msmcs-robotics/3d-models/readme.md

# 3D-Models

> Note: MSMCS Robotics Uses a **Promega M30** printer, so gcode may vary.
