msmcs-robotics/3d-models/promega3d-parts/External Filter Fan/RV7/Revision Notes.rtf

Revision Notes
External Filter Fan_RV7_1:
• New re-design based given constraints: filter should stand out, smooth, mass reduction, simple form, Strcutural printing mode (0.75 extrusion width, 0.3 layer height).
• Accomplishment: Not tested.
• Issues: Not Tested.
External Filter Fan_RV7_2:
• Premptively changed extrusion width to 1mm for structural printing mode (as requested)
• Accomplishments: Outer Fan Clip successfull. Part rigidity adequate
• Issues: Filter dimensions (length) is too short. Too much mass. Not a fixation on the blower side.
External Filter Fan_RV7_3:
• Changed filter length to 60 mm.
• Accomplishments: None.
• Issues: No enough clearance.
External Filter Fan_RV7_4:
• Added blower clip with a snap fit configuration. Reduced mass by reducing fillet on the duct edge (4 mm radius). Increased length to 60.2 mm
• Accomplishments: Filter fits. Bottom layer thickness provides enough rigidity (2.4 mm)
• Issues: Snap method is not reliable, due to wall flexibility. Had a request to remove visibility of filter. Lack of flexural resistance. M3 screws thru hole is too small.
External Filter Fan_RV7_5:
• Removed filter visibility. Switched to an interal clip fixation to blower. Increased fillet to 6 mm. Increased M3 thru hole to 4 mm.
• Accomplishments: M3 thru hole is successful. Internal clip successfull. Rigidity is confirmed.
• Issues: Air gap at the front region of the blower fan. Needs cover. Filter insert clearance taken up by fillet. Request to print in different print orientation. Request for shorter M3 screws. Overhang difficulties on the internal clip. Pan head clearance issues
External Filter Fan_RV7_6:
• Added front cover to the blower fan. Added filter fan clearance. Added chamfer to overhangs. Reoriented print base. Accomodate for M3 x 10. Adjusted pan head clearance issue.
• Accomplishments: Overhang compensation successful. Pan head clearance successful. Filter fan clearance successfull.
• Issues: Needs washer. Accomodate for length discrepancy.
External Filter Fan_RV7_7:
• Switched to M3 x12 and height compensation for washer input.
• Accomplishments: New print base approved. Height compensation and new screw switch succesfull
• Issues: Blower internal clip is too small (0.7 mm under model dimensions). The blower dimensions are out-dated as well. Needs update.
External Filter Fan_RV7_8:
• Added 0.6 mm total clearance for internal clip, side region (using updated blower dimensions).
• Accomplishments: Side clearance for internal clip successful.
• Issues: Internal clip needs larger clearance on top region.
External Filter Fan_RV7_9:
• Added 0.6 mm total clearance for internal clip, top region, (using updated blower dimensions).
• Accomplishments: Clip clearance is sufficient.
• Issues: Filter clearance is not adequate (started printing with production printers, need modifications). Inconsistent bed adhesion (regional).
External Filter Fan_RV7_10:
• New filter clearance (60.4 x 13.3). Addressed bridging issues with the blower cover region. Addressed minor face misalignment issues. Added custom brim.
• Accomplishments: Better bridging performance. Custom brim performs function adequately.
• Issues: Subtle bridging issues need to be addressed. Increase filter fan clearance.
External Filter Fan_RV7_11:
• Increased filter clearance to 61 x 14 mm. Fixed model-based, minor bridging issue.
• Accomplishments: Pending.
• Issues: Pending.
External Filter Fan_RV7_12:
• Added changes make inverted printed plane possible. (along z axis)
• Accomplishments: Print dimensions more accurate. Needs support though.
• Issues: Pending.
