msmcs-robotics/3d-models/promega3d-parts/Quad-Mega Adapter/Mega Adapter 1.0/Revision Notes.rtf

Revision Notes
Mega Adapter (& Mirrored)_2:
• Change M3 screw position to allow tightening of printed parted into quad and allow addition fixation of the quad itself (between its two parts)
• Accomplishment: Screws into the quad, without problems (assembly-wise)
• Issues: Sliding interface with x shaft was: ABSR-chrome plate. Not good, switch to igus bearings.
Mega Adapter (& Mirrred)_3:
• Added igus clearance fitting
• Accoplishment: Proof of concept confirmed. Can fit sheet-metal-intended igus bearings into printed part.
• Issues: The igus bearing barely fits into the clearance. Cannot sliding x shaft into igus bearings. Needs more clearance adjustment.
Mega Adapter (& Mirrored)_4:
• Increase diam clearance in igus bearing fitting, based on diams measured when igus bearing was on x shaft.
• Accomplishment: X shaft can slide into bearing. Igus bearings install cleanly into printed part.
• Issues: Too much frictional load (seen in one igus bearing interface). Increase igus bearing clearance.
Mega Adapter (& Mirrored)_5:
• Increased igus bearing fitting diam. to reduce fricational load
• Accomplishment: Slides better.
• Issues: Need to address integration of fan mounts, cable harness, and bed switch holder. Current adapter design cannot conform adequately without serious modifications to the already-made parts. Will have to do a major revision.
• REFER TO MEGA ADAPTER 2.0
