msmcs-robotics/3d-models/promega3d-parts/Quad-Mega Adapter/Mega Adapter 2.0/Revision Notes.rtf

Revision Notes:
Mega Adapter 2.0.1:
• New adapter design. Conforms to cable harness M3 thru holes. Conforms to fan mount position. Secures to quad extruder in all 3 axes. ( 6 screws)
• Accomplishment: Cable harness attachment sucessfull. Quad extruder attachment successful. Igus bearin and x shaft installation sucessfull. Adequate frictional loading.
• Issues: Print issues with M3 pan head clearance.
Mega Adapter 2.0.2:
• Resolved M3 pan head overhang issue.
• Accomplishment: M3 pan head placement is accurate.
• Issues: No adaptation to the bed switch.
Mega Adapter 2.0.3:
• Added bed switch adaption. New Offset config values (signs are not confirmed, values are not confirmed):
With Lever: X-3.5 Y37.45 (Model Values)
W/o lever: X-3.5 Y30 (Model Values)
• Accomplishment: Bed switch toggle between disengage and engage is sucessfull. Minimal possibility of snagging when bed hits engaged bed switch.
• Issues: Bed Switch not well secured, in the z direction
Mega Adapter 2.0.4:
• New bed switch positioning solution. Offset values will be given when functionality is verified.
• Accomplishment: Bed switch secure in the z direction. The disengage position is fully fixated.
• Issues: The engage position is partially fixated, wobble in the XY plane. The wires coming of the endstop are causing clearance problems.

Mega Adapter 2.0.5:
• Applied same concept of disengage position's fixation to the the engage position. Added wire clearance
• Accomplishment: Wire clearance succesffull. Engaged position has better fixation, not fully acceptable yet.
• Issues: Modified heater block for quad conflicts with disengaged position of the bed switch. Need new position for disengaged bed switch.
Mega Adapter 2.0.6:
• New bed switch position configuration
• Accomplishment: Bed switch configuration is successfull.
• Issues: X axis range is limited because the fans hit the idlers. No consideration of CoreXY belt clamping
Mega Adapter 2.0.7:
• New CoreXY clamping integration. Lowered quad position (relative to X shaft) to for belt clearance.
• Accomplishment: Integration successful.
• Issues: Pan head crushes into print during clamping (needs washer consideration). Left over CoreXY belt needs routing. Plates rotate during fixation, needs to stay straight. Need larger print thickness to clamp CoreXY down harder. Need wire clearance for the back motors. Need thru hole for the cable harness. CRITICAL ISSUE: Flexing occurs where the belt clamping is done, the extension(from the base to the clamping position is too high). May have to reconsider reposition of quad for better rigidity. New revision may be pursued.
Mega Adapter 2.0.8:
• Added support bars close to the application force, should reduce flexing by some degree. Switched to a snug fit belt fixation method. Hid the termation of the belt fixation.
• Accomplishment: Flexion reduction successfull, now feasible fixation mechanism.
• Issues: Clearance issues with insertions of different parts. Needs thru hole for cable harness fixation. Needs more heater air gap. Current belt fixation method is not feasible.
Mega Adapter 2.0.9:
• Switching to a crimp-belt fixation method with a secondary clamping mechanism from the motors, as the quad head is fixed into place. Have a 4.0mm heater air gap. All insertion clearances adjusted for. Added better form factor (merging region between different printed parts).
• Accomplishment: CoreXY belt clamping partially successful. The grip is descent, needs a secondary reinforcement. Better form factor.
• Issues: Need secondary belt grip.
Mega Adapter 2.0.10:
• Added a secondary belt grip.
• Accomplishment: Belt grip successfull.
• Issues: Needs bed switch clearance increase.
Mega Adapter 2.0.11:
• Changed belt insertion direction. Changed direction of belt grip. Increased bed switch clearance to 3.5 mm (prev. 3.4). Minor asesthetic changes.
• Accomplishment: Bed switch clearance adequate. Asesthetic changes approved.
• Issues: Other bed switch clearance needs adjustment. Angle of belt mating is not completely functional
Mega Adapter 2.0.12:
• New orientation for belt mating and new insertion belt position. Increased bed switch clearance from 11 mm to 11.2 mm.
• Accomplishment: New Belt orientation is preffered,compared to other orientation. Bed switch performance is adequate (minor issues).
• Issues: Belt grip is not enough (too much clearance).
Mega Adapter 2.0.13:
• Decreased belt clearance from 1.2 to .95 mm (reference to smallest belt thickness in belt profile. Decreased m3 locknut clearance to 5.55 (prev. 5.6). Removed angled clearance and now a locknut insertion clearance with a screw length clearance (no bottoming out).
• Accomplishment: None.
• Issues: Belt mating starts slipping at high loads. Will play it safe and decrease mating clearance. M3 locknut clearances are not adequate. M3 tap holes are not helping assembly. M3 pan head clearance needs to be increased. Belt clamp through the quad head needs more clamping. Motor wire clearance needs to be addressed. Bed switch clearance needs improvement. One of the asesthetic fillets is hard to print.
Mega Adapter 2.0.14:
• Changed all M3 tap holes to thru holes (3.8 mm). Increased M3 pan head clearance to 6.5 mm. Decreased belt insertion clearance from 1.1 mm to 0.9 mm (quad should grip the belt tighter). Reduced belt tooth mating clearance from 0.1 mm (prev) to 0.05mm. Determined that there is no need for wire clearance accomodation. Reduced m3 lockunut insertion clearance to 5.45 mm (width & length) x 4.2 mm (height). Increased bed switch height clearance to 11.4 mm (prev 11.1). Changed asesthetic fillet to a 45 chamfer with a fillet transitioning toward the top.
• Accomplishment: Pending.
• Issues: Cable harness position is too low.
Mega Adapter 2.0.15:
• Shifted the cable harness location higher.
• Accomplishment: Bed switch functionality verified. Belt mating is quite good. M3 locknut clearance better. Quad belt grip better.
• Issues: Hitting limit switch is a problem. (both in x Y position). Address minor prnt issue with M3 lock nut casing.
Mega Adapter 2.0.16:
• Added heater cartidge wire clearance. Add extension to hit limit switch properly. Increase print base length by 3 mm.
• Accomplishment: Pending.
• Issues: Pending.
