msmcs-robotics/3d-models/promega3d-parts/Sliders/RV7/Revision Notes.rtf

Revision Notes
Slider_RV7_1:
• A cumulation of iteration designs on the z sliders. This is current production z slider iteration.
• Accomplishments: Dismissed
• Issues: "arms" are breaking during shipping. Needs z axis adjustability (+- 1mm)
Slider_RV7_2:
• Increase arm thickness by 50% (prev= 3.9 mm, new=5.85 mm). Added 0.8 +- mm z axis adjustment (limited by interference with M3 pan head)
• Accomplishments: Thickening completed.
• Issues: M3 nut can rotate freely when inserted. Need larger M3 thru slot.
Slider_RV7_3:
• Decreased M3 nut clearance to 5.5 mm, previous 5.7. Increased slot diameter to 3.6 mm
• Accomplishments: M3 slot clearance is verified.
• Issues: M3 nut is well-secured. Rough sliding (takes quiet a bit of force to slide it to position).
Slider_RV7_4:
• Increased nut clearance to 5.6 mm
• Accomplishments: Nut clearance is functional. Pending shipping test results
• Issues: Request to add fillets on corner.
Slider_RV7_5:
• Added corner reduction to intended edge.
• Accomplishments: Changes approved. Pending on test results.
• Issues: Nut clearance (on the fillet side) needs more clearance. Other side is fine.
Slider_RV7_6:
• Increased specific nut clearance to 5.7 x 4.3 mm (fillet side).
• Accomplishments: Samples worked.
• Issues: Batch prints have dimensional variances, need to adjust.
Slider_RV7_7:
• The nut clearance was adjusted for batch printing.
• Accomplishments: Pending.
• Issues: Pending.
