msmcs-robotics/3d-models/hello-world/stl/roundPhoneDock.stl

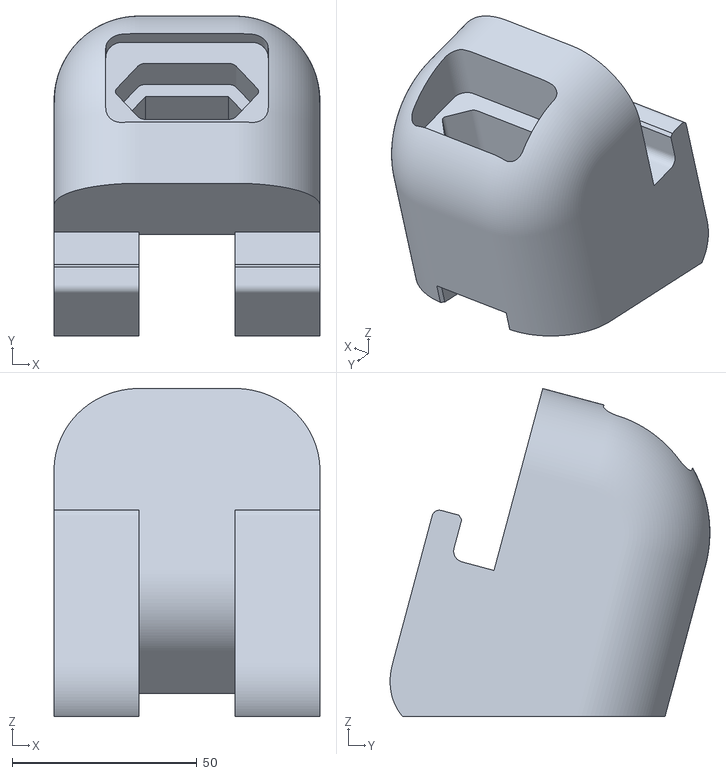
[picture p1: CAD file, 2021-11-17]
hello-world/stl/roundPhoneDock.stl
72.0 x 86.6 x 88.8
