msmcs-robotics/3d-models/mini-rockets/rocket_v2_fins.stl

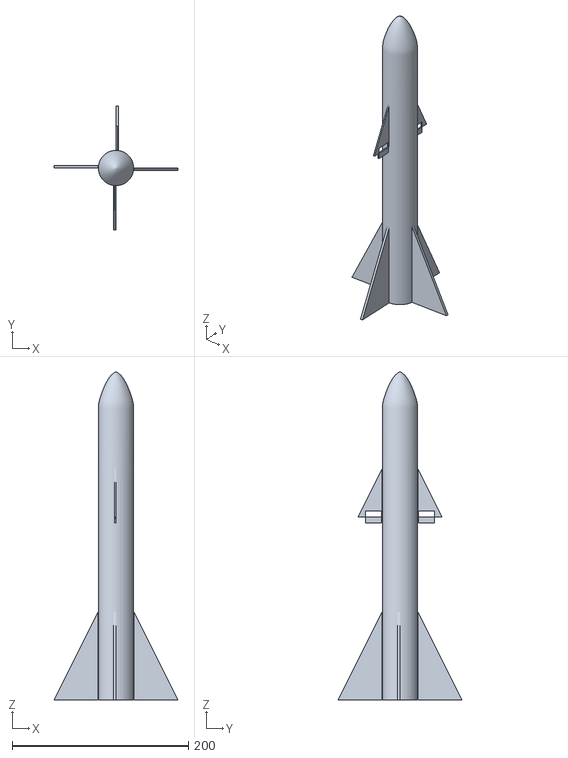
[picture p2: CAD file, 2022-01-28]
mini-rockets/rocket_v2_fins.stl
140.4 x 140.4 x 372.1
