msmcs-robotics/3d-models/promega3d-parts/External Filter Fan/RV3/External Filter Fan_RV3_LeftDuct_5.STL

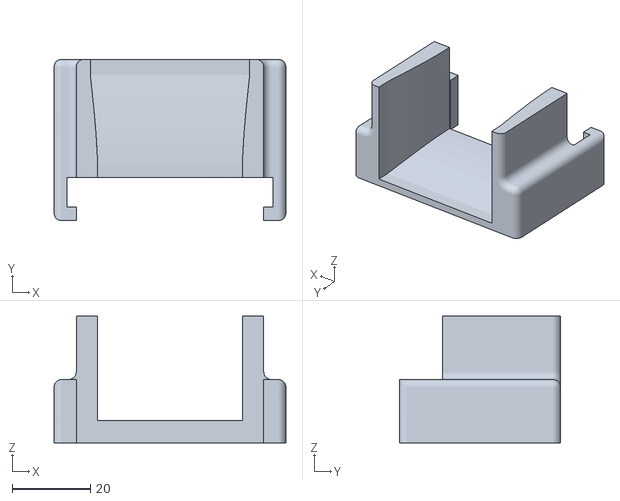
[picture p3: CAD file, 2022-01-12]
promega3d-parts/External Filter Fan/RV3/External Filter Fan_RV3_LeftDuct_5.STL
59.4 x 41.3 x 32.4
