msmcs-robotics/3d-models/promega3d-parts/External Filter Fan/RV4/External Filter Fan_RV4_LD_3.STL

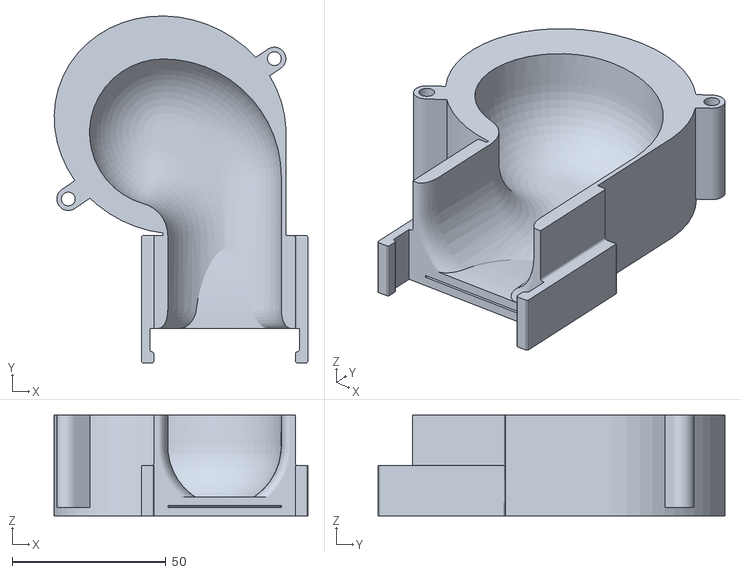
[picture p4: CAD file, 2022-01-12]
promega3d-parts/External Filter Fan/RV4/External Filter Fan_RV4_LD_3.STL
82.6 x 113.0 x 32.8
