msmcs-robotics/3d-models/promega3d-parts/External Filter Fan/RV5/External Filter Fan RV5_1.STL

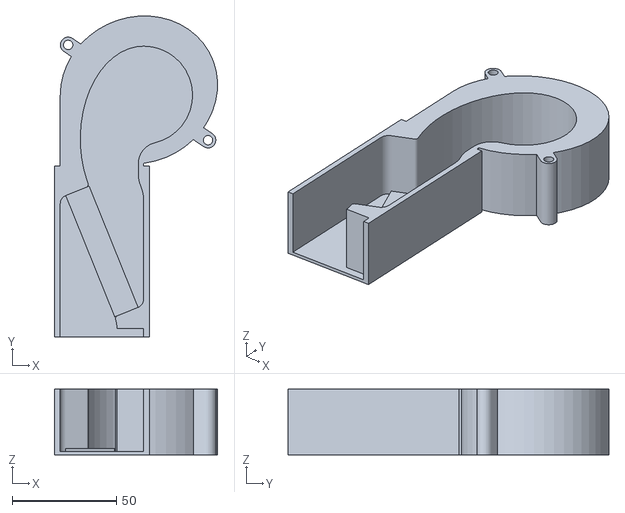
[picture p5: CAD file, 2022-01-12]
promega3d-parts/External Filter Fan/RV5/External Filter Fan RV5_1.STL
78.2 x 153.9 x 31.5
