msmcs-robotics/3d-models/promega3d-parts/External Filter Fan/RV7/External Filter Fan_RV7_2.STL

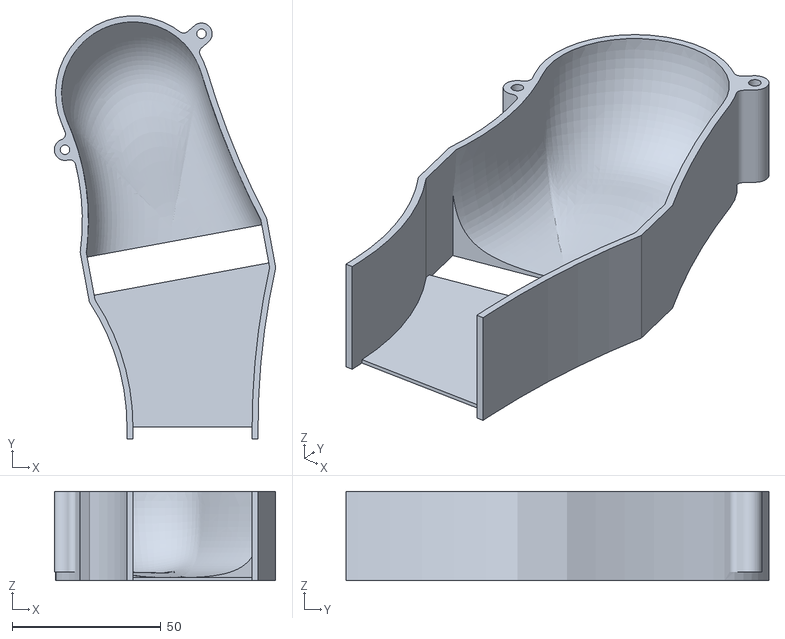
[picture p6: CAD file, 2022-01-12]
promega3d-parts/External Filter Fan/RV7/External Filter Fan_RV7_2.STL
74.3 x 142.0 x 30.0
