msmcs-robotics/3d-models/promega3d-parts/Sliders/RV7/Slider_RV7_6.STL

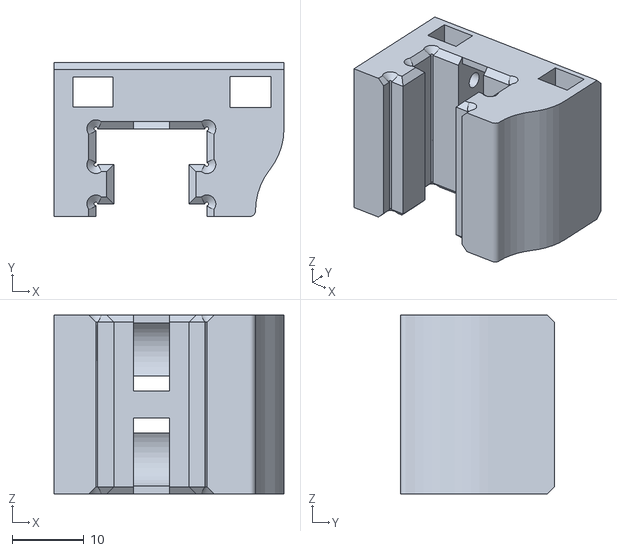
[picture p10: CAD file, 2022-01-12]
promega3d-parts/Sliders/RV7/Slider_RV7_6.STL
32.1 x 21.5 x 25.0
