msmcs-robotics/3d-models/promega3d-parts/Y Limit Switch Holder/Y Limit Switch Holder_RV3_10.STEP

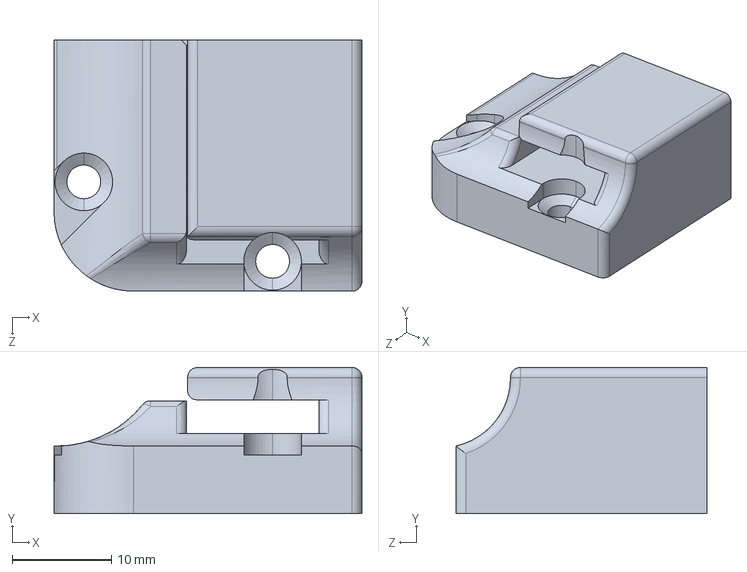
[picture p11: CAD file, 2022-01-12]
promega3d-parts/Y Limit Switch Holder/Y Limit Switch Holder_RV3_10.STEP
31.0 x 14.7 x 25.3 mm
