msmcs-robotics/3d-models/mini-rockets/rocket_v2.stl

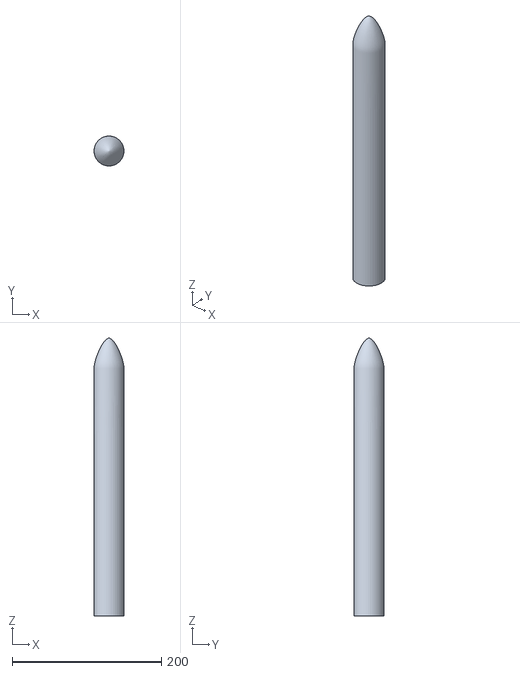
[picture p12: CAD file, 2022-01-28]
mini-rockets/rocket_v2.stl
40.0 x 40.0 x 372.1
