msmcs-robotics/3d-models/promega3d-parts/External Filter Fan/RV3/External Filter Fan_RV3_LeftFilter_7.STL

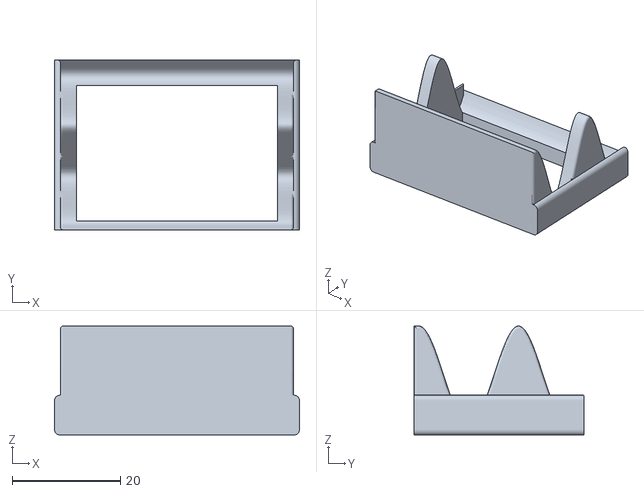
[picture p13: CAD file, 2022-01-12]
promega3d-parts/External Filter Fan/RV3/External Filter Fan_RV3_LeftFilter_7.STL
45.2 x 31.3 x 20.1
