msmcs-robotics/3d-models/promega3d-parts/External Filter Fan/RV4/External Filter Fan_RV4_RFC_1.STL

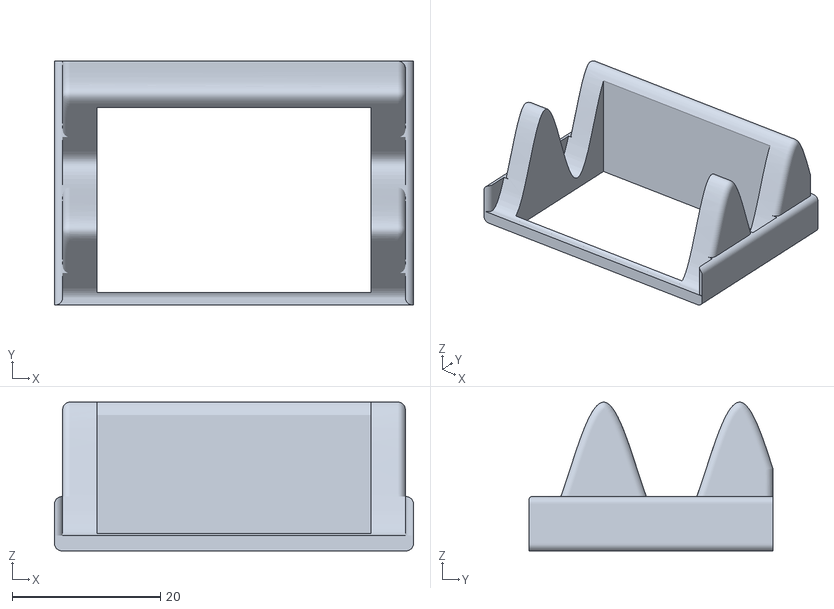
[picture p14: CAD file, 2022-01-12]
promega3d-parts/External Filter Fan/RV4/External Filter Fan_RV4_RFC_1.STL
48.5 x 33.0 x 20.1
