msmcs-robotics/3d-models/promega3d-parts/External Filter Fan/RV5/External Filter Fan RV5_4.STL

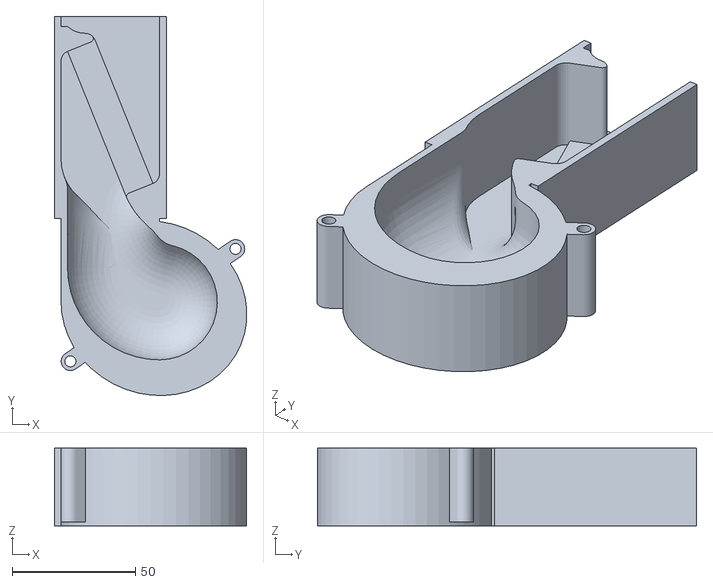
[picture p15: CAD file, 2022-01-12]
promega3d-parts/External Filter Fan/RV5/External Filter Fan RV5_4.STL
78.2 x 154.0 x 31.5
