msmcs-robotics/3d-models/promega3d-parts/Nozzle Fan Guide/Nozzle Fan Guide 2.0/Nozzle Fan Guide 2.0.1.STL

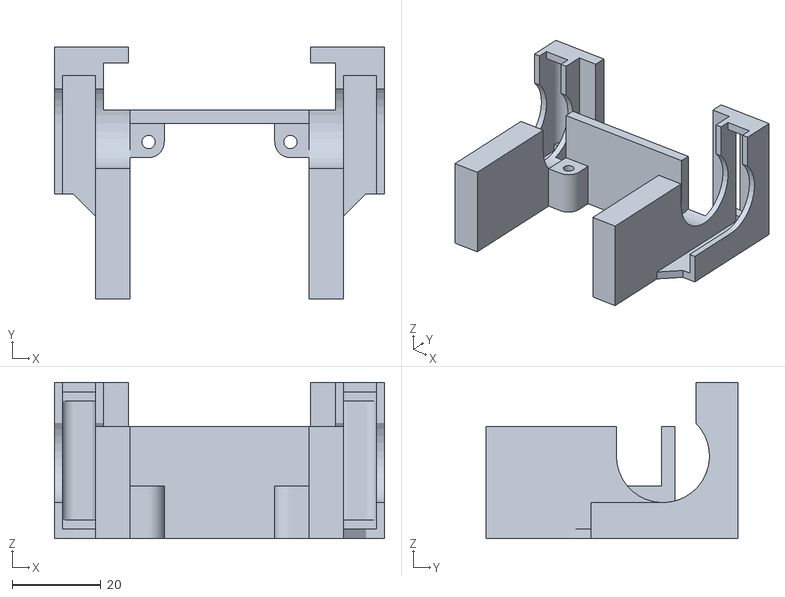
[picture p17: CAD file, 2022-01-12]
promega3d-parts/Nozzle Fan Guide/Nozzle Fan Guide 2.0/Nozzle Fan Guide 2.0.1.STL
74.5 x 57.0 x 35.3
