msmcs-robotics/3d-models/promega3d-parts/Quad-Mega Adapter/Mega Adapter 2.0/Mega Adapter 2.0.18.STL

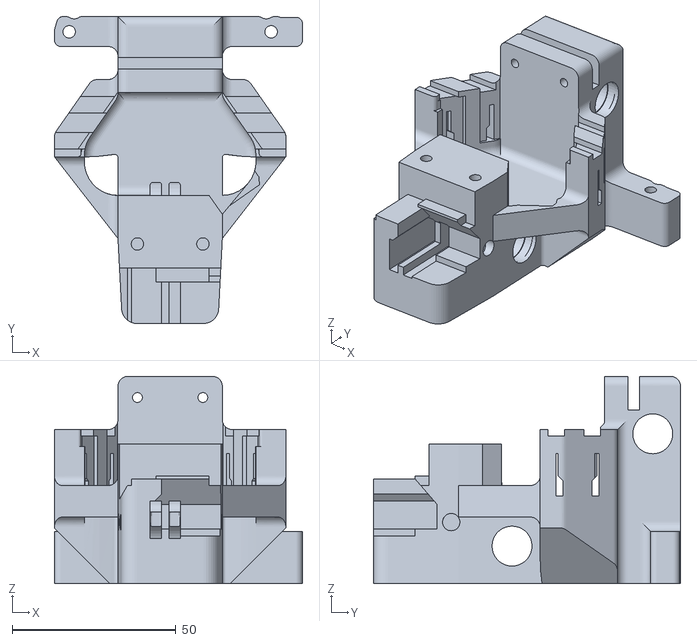
[picture p19: CAD file, 2022-01-12]
promega3d-parts/Quad-Mega Adapter/Mega Adapter 2.0/Mega Adapter 2.0.18.STL
75.8 x 93.8 x 63.3
