msmcs-robotics/3d-models/promega3d-parts/Y Limit Housing XL(For Long Motors)/Y Limit Housing XL V2_2.stl

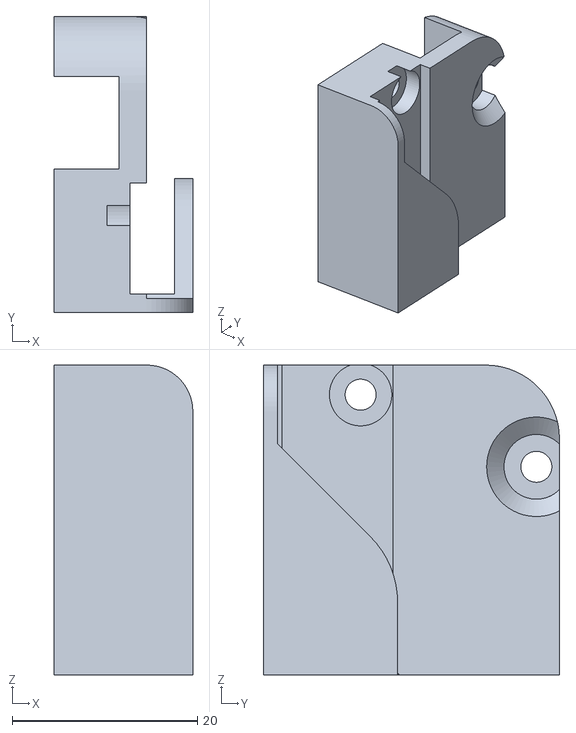
[picture p21: CAD file, 2022-01-12]
promega3d-parts/Y Limit Housing XL(For Long Motors)/Y Limit Housing XL V2_2.stl
15.0 x 32.0 x 33.5
