msmcs-robotics/3d-models/promega3d-parts/External Filter Fan/RV4/External Filter Fan_RV4_LD_1.STL

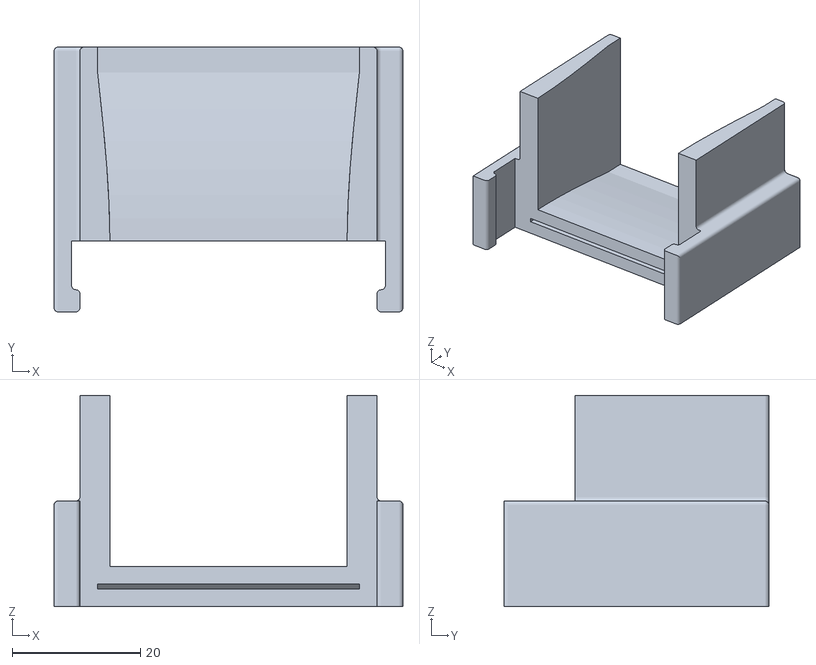
[picture p22: CAD file, 2022-01-12]
promega3d-parts/External Filter Fan/RV4/External Filter Fan_RV4_LD_1.STL
54.4 x 41.3 x 33.0
