msmcs-robotics/3d-models/promega3d-parts/External Filter Fan/RV7/External Filter Fan_RV7_12.STL

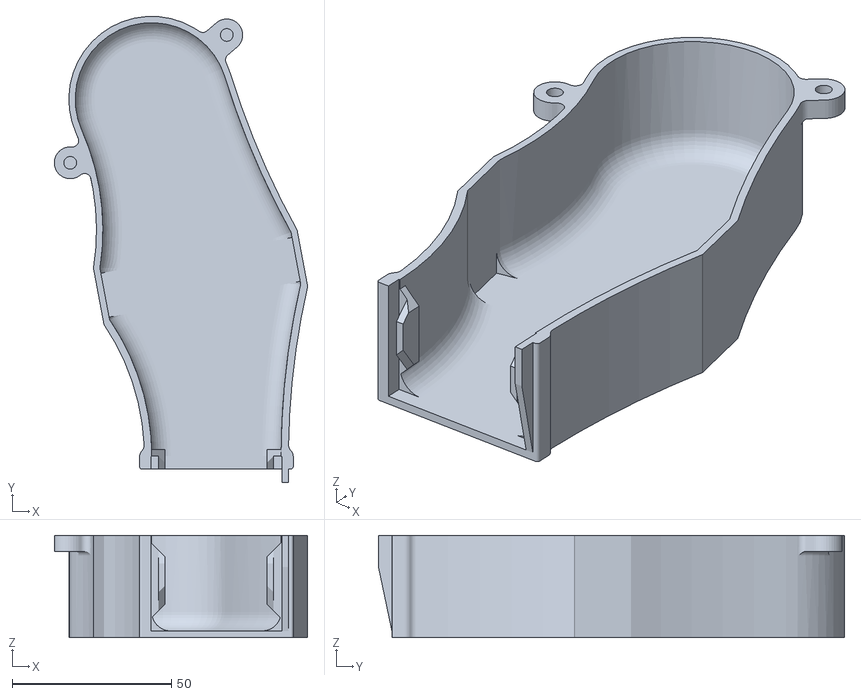
[picture p23: CAD file, 2022-01-12]
promega3d-parts/External Filter Fan/RV7/External Filter Fan_RV7_12.STL
79.5 x 146.2 x 32.1
