msmcs-robotics/3d-models/promega3d-parts/Nozzle Fan Guide/Nozzle Fan Guide 2.0/Nozzle Fan Guide 2.0.18.STL

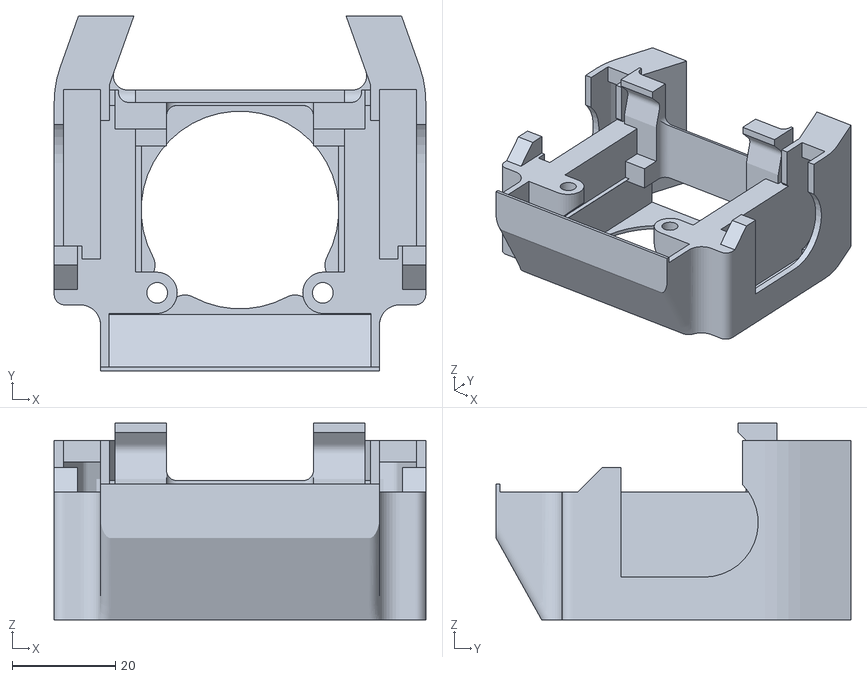
[picture p24: CAD file, 2022-01-12]
promega3d-parts/Nozzle Fan Guide/Nozzle Fan Guide 2.0/Nozzle Fan Guide 2.0.18.STL
71.8 x 68.6 x 38.0
