msmcs-robotics/3d-models/promega3d-parts/Quad-Mega Adapter/Mega Adapter 1.0/Mega Adapter Mirrored_4.STL

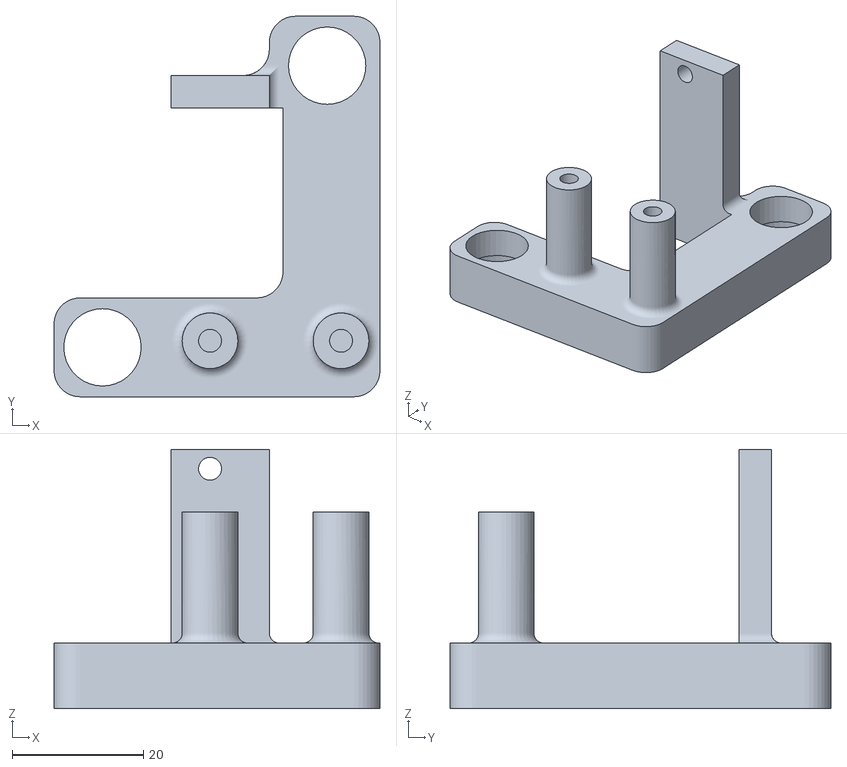
[picture p25: CAD file, 2022-01-12]
promega3d-parts/Quad-Mega Adapter/Mega Adapter 1.0/Mega Adapter Mirrored_4.STL
49.8 x 58.1 x 39.6
