msmcs-robotics/3d-models/promega3d-parts/Quad-Mega Adapter/Mega Adapter 2.0/Mega Adapter 2.0.10.STL

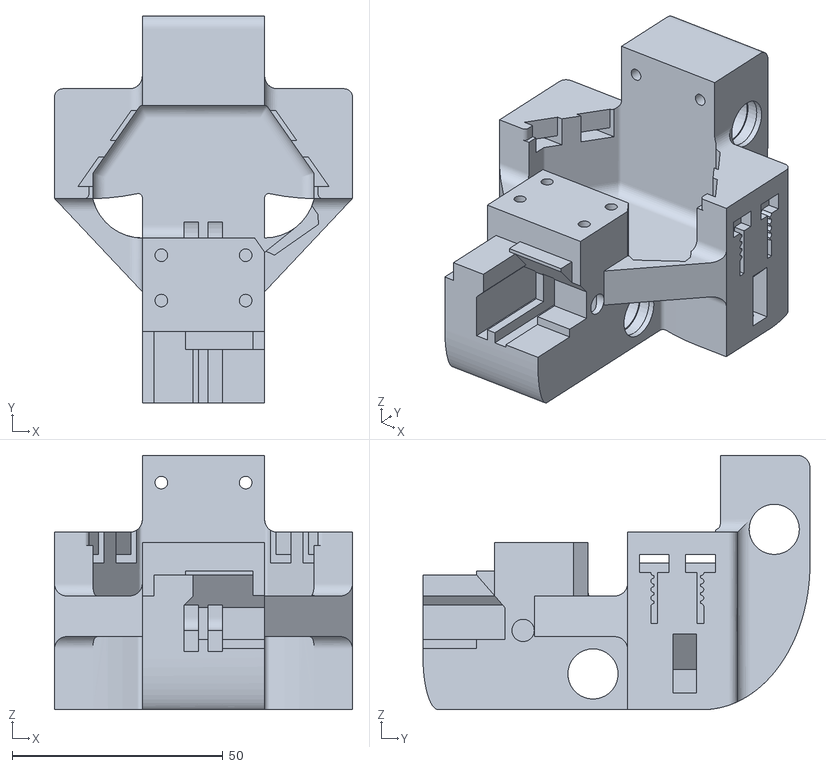
[picture p26: CAD file, 2022-01-12]
promega3d-parts/Quad-Mega Adapter/Mega Adapter 2.0/Mega Adapter 2.0.10.STL
70.7 x 91.8 x 60.3
