msmcs-robotics/3d-models/promega3d-parts/External Filter Fan/RV4/External Filter Fan_RV4_RFC_2.STL

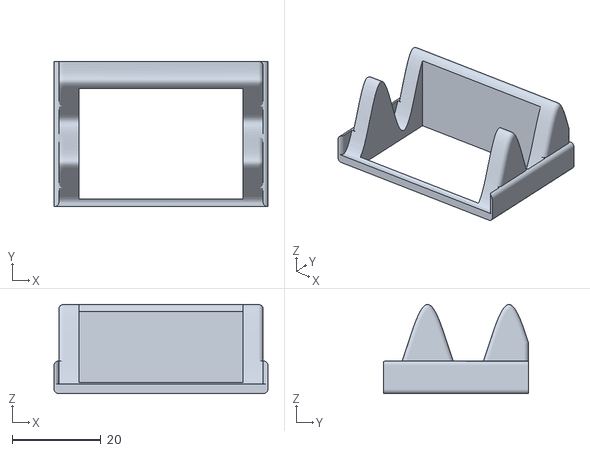
[picture p28: CAD file, 2022-01-12]
promega3d-parts/External Filter Fan/RV4/External Filter Fan_RV4_RFC_2.STL
48.3 x 32.8 x 20.1
