msmcs-robotics/3d-models/promega3d-parts/Nozzle Fan Guide/Nozzle Fan Guide 2.0/Nozzle Fan Guide 2.0.7.STL

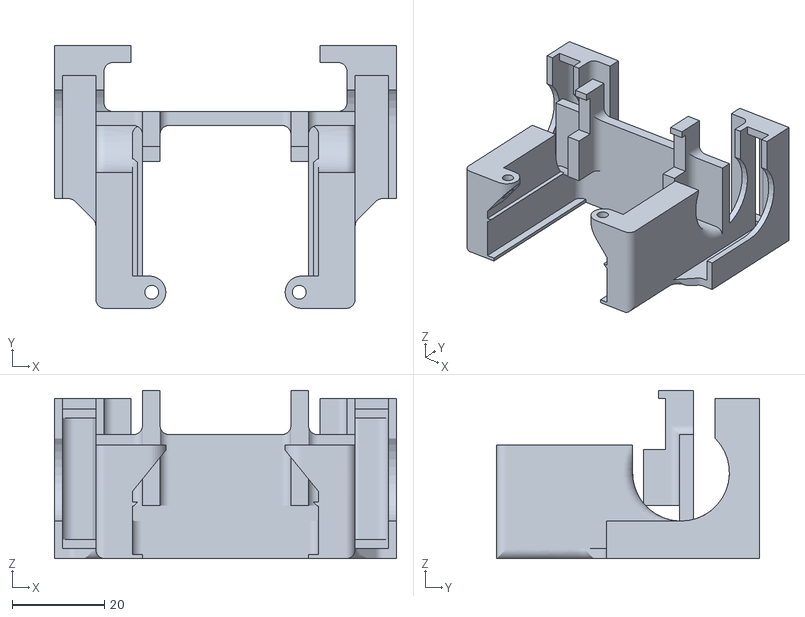
[picture p29: CAD file, 2022-01-12]
promega3d-parts/Nozzle Fan Guide/Nozzle Fan Guide 2.0/Nozzle Fan Guide 2.0.7.STL
74.2 x 57.0 x 36.5
