msmcs-robotics/3d-models/promega3d-parts/Quad-Mega Adapter/Mega Adapter 1.0/Mega Adapter Mirrored_1.STL

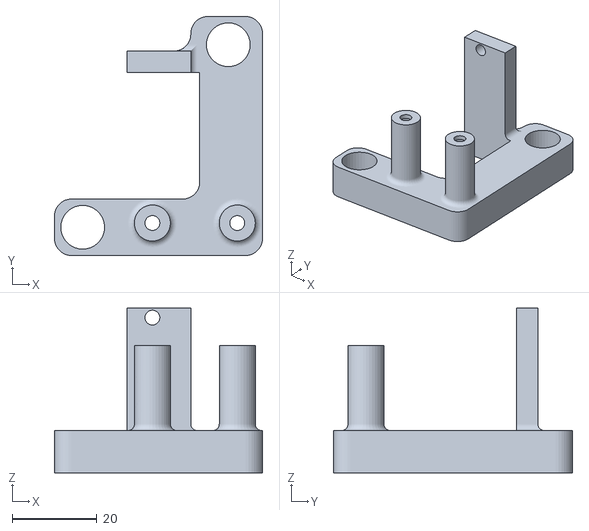
[picture p30: CAD file, 2022-01-12]
promega3d-parts/Quad-Mega Adapter/Mega Adapter 1.0/Mega Adapter Mirrored_1.STL
49.0 x 56.3 x 38.9
