msmcs-robotics/3d-models/promega3d-parts/Sliders/RV7/Slider_RV7_1.STL

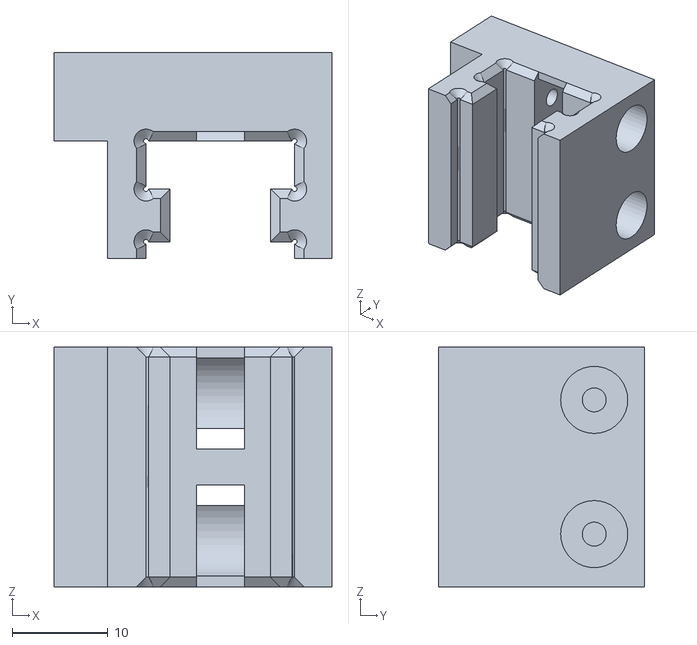
[picture p31: CAD file, 2022-01-12]
promega3d-parts/Sliders/RV7/Slider_RV7_1.STL
29.0 x 21.5 x 25.0
