msmcs-robotics/3d-models/promega3d-parts/External Filter Fan/RV3/External Filter Fan_RV3_LeftFilter_6.STL

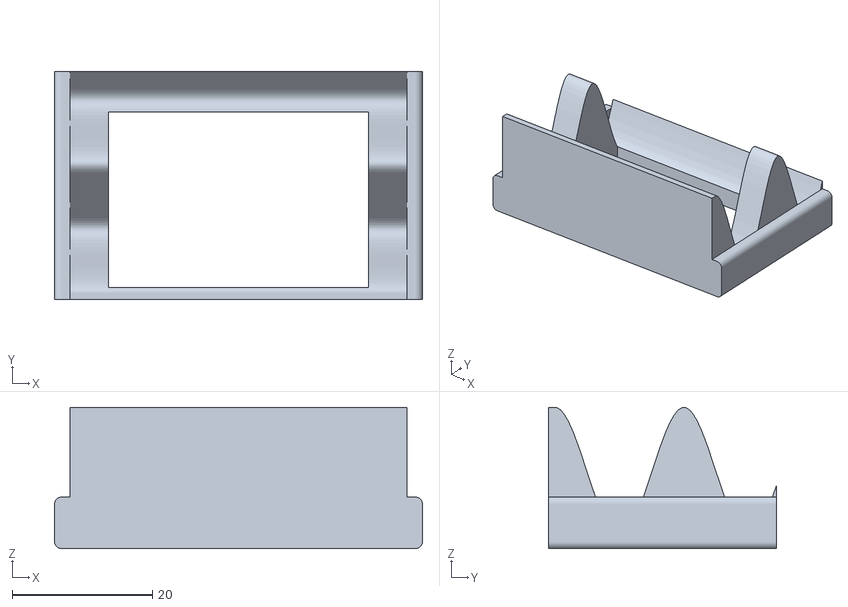
[picture p32: CAD file, 2022-01-12]
promega3d-parts/External Filter Fan/RV3/External Filter Fan_RV3_LeftFilter_6.STL
52.4 x 32.4 x 20.1
