msmcs-robotics/3d-models/promega3d-parts/External Filter Fan/RV4/External Filter Fan_RV4_RD_1.STL

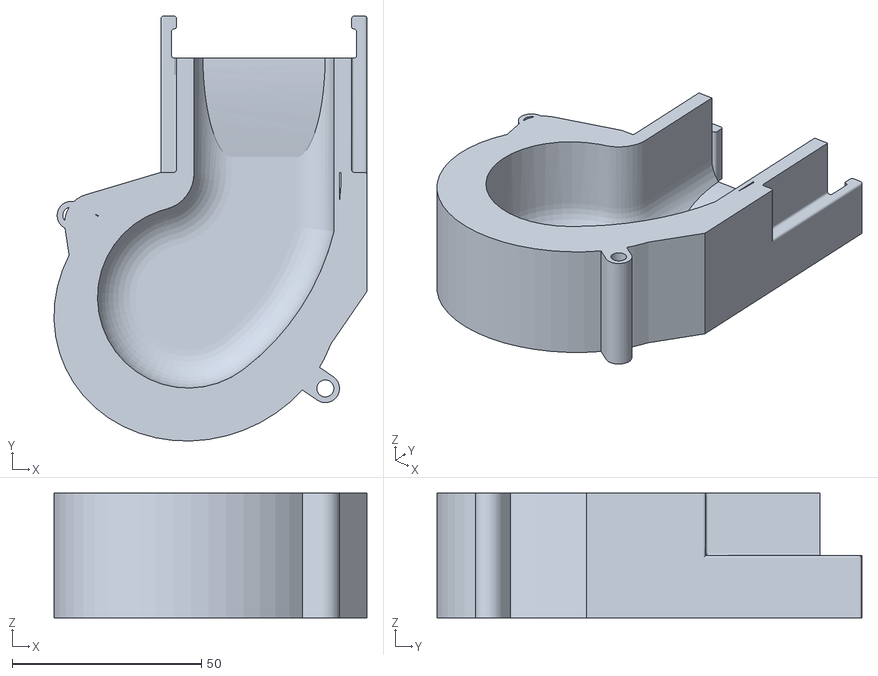
[picture p35: CAD file, 2022-01-12]
promega3d-parts/External Filter Fan/RV4/External Filter Fan_RV4_RD_1.STL
82.7 x 112.3 x 33.0
