msmcs-robotics/3d-models/promega3d-parts/External Filter Fan/RV7/External Filter Fan_RV7_4.STL

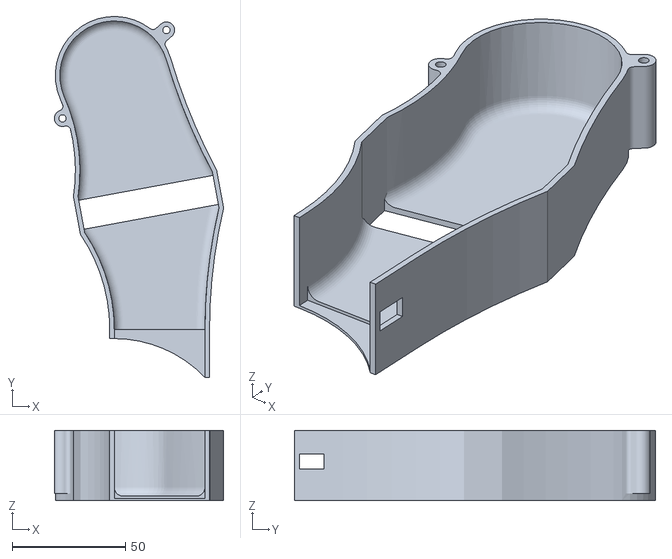
[picture p36: CAD file, 2022-01-12]
promega3d-parts/External Filter Fan/RV7/External Filter Fan_RV7_4.STL
74.6 x 159.1 x 30.9
