msmcs-robotics/3d-models/promega3d-parts/Quad-Mega Adapter/Mega Adapter 2.0/Mega Adapter 2.0.16.STL

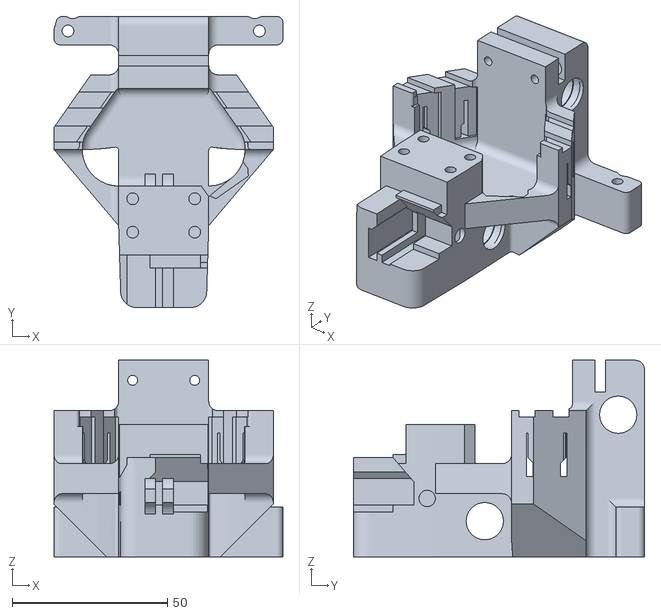
[picture p37: CAD file, 2022-01-12]
promega3d-parts/Quad-Mega Adapter/Mega Adapter 2.0/Mega Adapter 2.0.16.STL
73.8 x 93.8 x 63.3
