msmcs-robotics/3d-models/promega3d-parts/Quad-Mega Adapter/Mega Adapter 1.0/Mega Adapter_5.STL

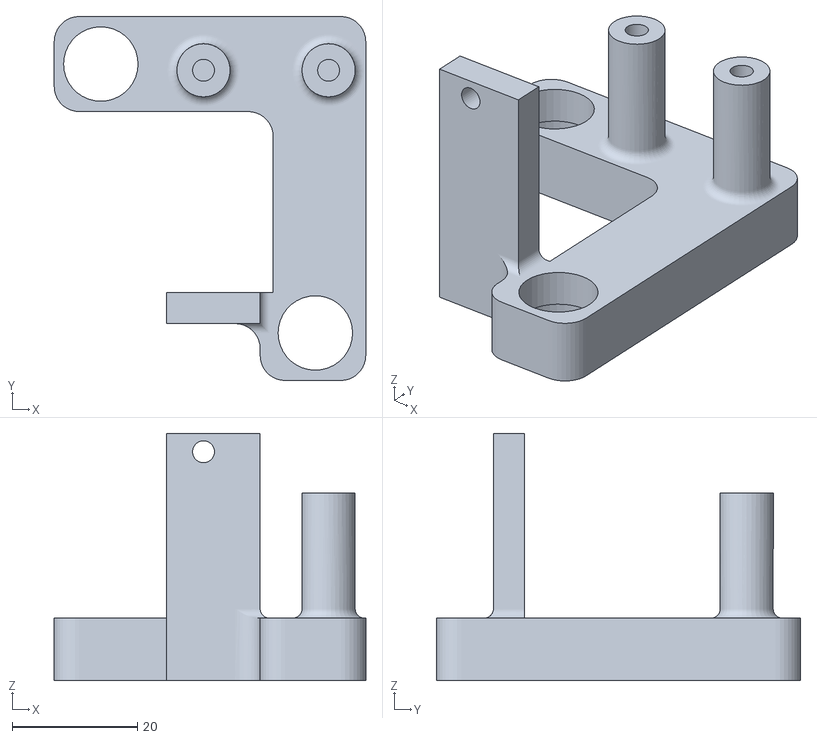
[picture p40: CAD file, 2022-01-12]
promega3d-parts/Quad-Mega Adapter/Mega Adapter 1.0/Mega Adapter_5.STL
49.8 x 58.2 x 39.6
