msmcs-robotics/3d-models/promega3d-parts/External Filter Fan/RV3/External Filter Fan_RV3_RightDuct_6.STL

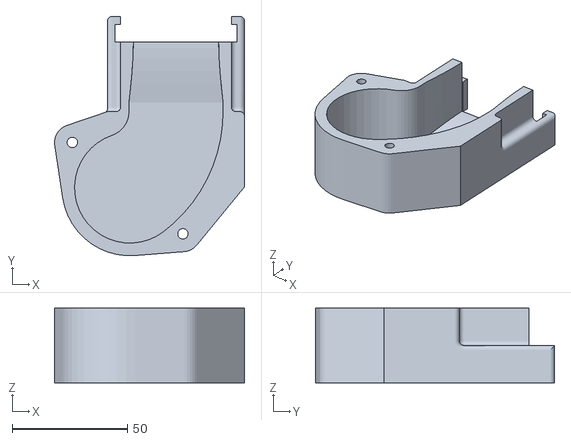
[picture p41: CAD file, 2022-01-12]
promega3d-parts/External Filter Fan/RV3/External Filter Fan_RV3_RightDuct_6.STL
82.4 x 103.8 x 32.4
