msmcs-robotics/3d-models/promega3d-parts/External Filter Fan/RV7/External Filter Fan_RV7_1.STL

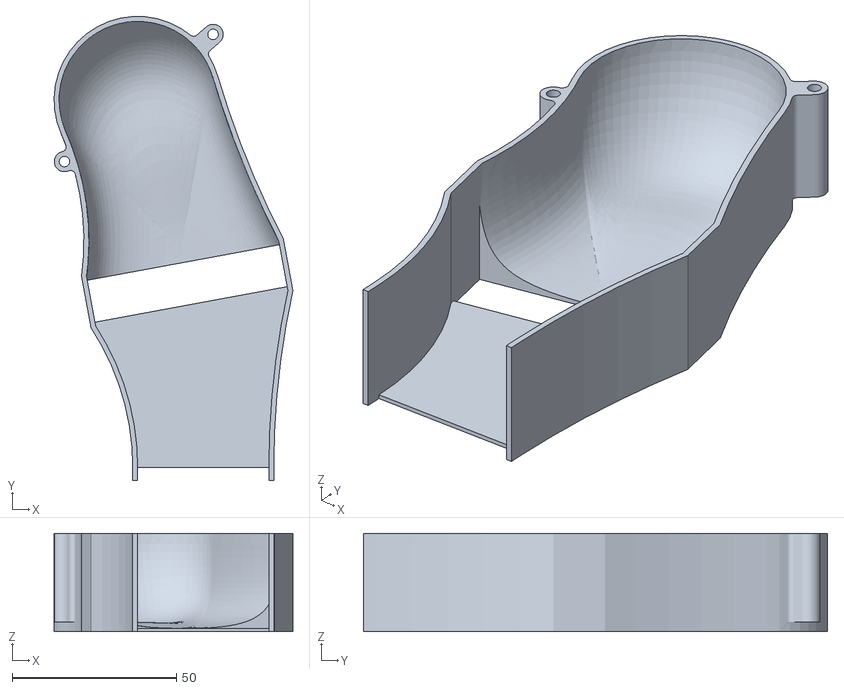
[picture p43: CAD file, 2022-01-12]
promega3d-parts/External Filter Fan/RV7/External Filter Fan_RV7_1.STL
72.8 x 141.5 x 30.0
