msmcs-robotics/3d-models/promega3d-parts/Quad-Mega Adapter/Mega Adapter 2.0/Mega Adapter 2.0.1.STL

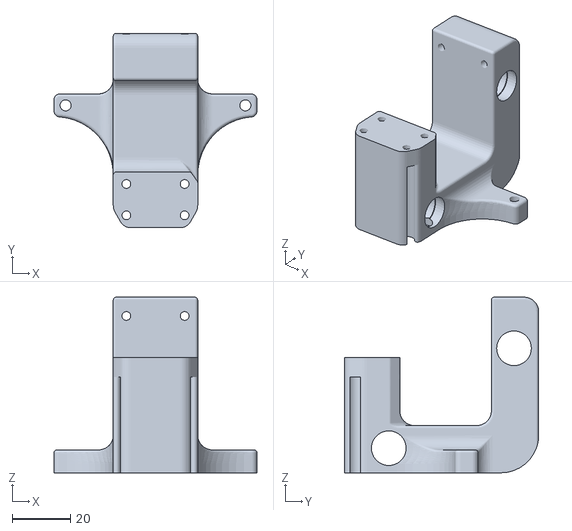
[picture p45: CAD file, 2022-01-12]
promega3d-parts/Quad-Mega Adapter/Mega Adapter 2.0/Mega Adapter 2.0.1.STL
69.7 x 66.8 x 60.3
