msmcs-robotics/3d-models/promega3d-parts/External Filter Fan/RV3/External Filter Fan_RV3_LeftDuct_7.STL

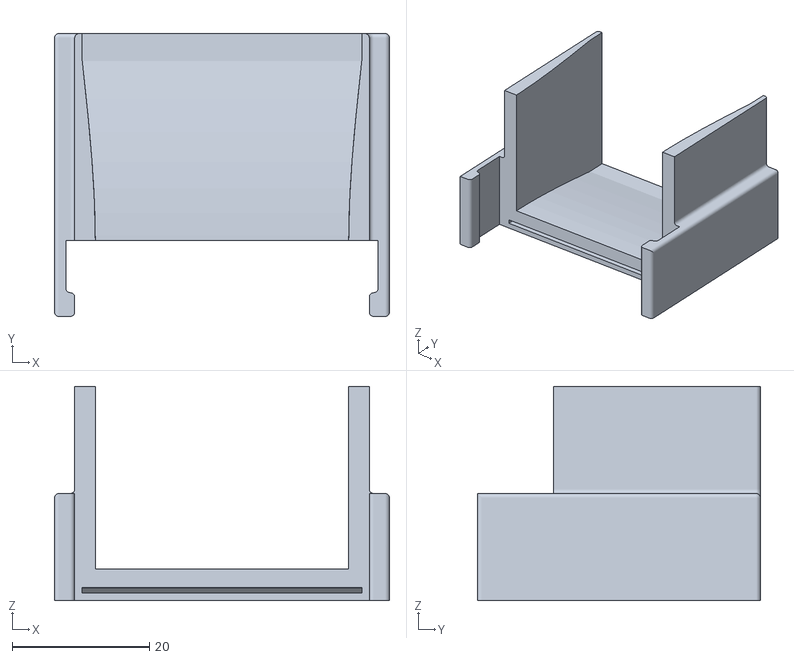
[picture p46: CAD file, 2022-01-12]
promega3d-parts/External Filter Fan/RV3/External Filter Fan_RV3_LeftDuct_7.STL
48.9 x 41.3 x 31.3
