msmcs-robotics/3d-models/promega3d-parts/External Filter Fan/RV3/External Filter Fan_RV3_RightDuct_7.STL

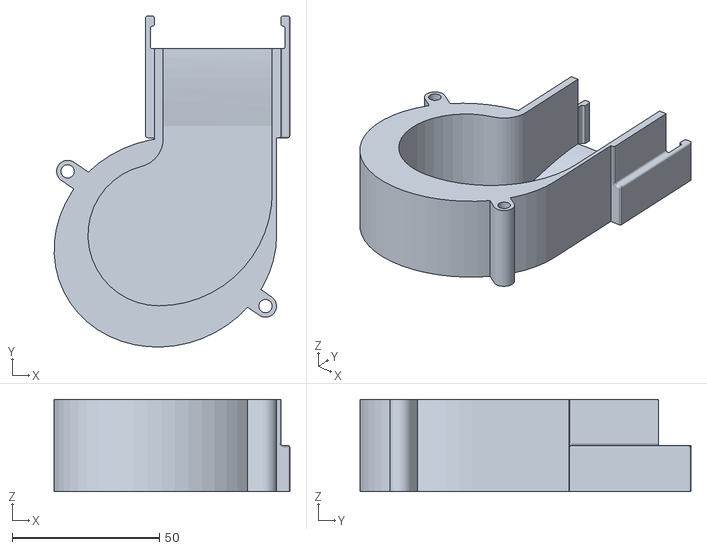
[picture p50: CAD file, 2022-01-12]
promega3d-parts/External Filter Fan/RV3/External Filter Fan_RV3_RightDuct_7.STL
79.9 x 112.3 x 31.3
