msmcs-robotics/3d-models/(list of files, cad)

Other CAD files:
promega3d-parts/External Filter Fan/RV3/External Filter Fan_RV3_LeftDuct_6.STL
promega3d-parts/External Filter Fan/RV5/External Filter Fan RV5_3.STL
promega3d-parts/Sliders/RV7/Slider_RV7_4.STL
promega3d-parts/External Filter Fan/RV5/External Filter Fan RV5_2.STL
promega3d-parts/External Filter Fan/RV7/External Filter Fan_RV7_9.STL
promega3d-parts/Quad-Mega Adapter/Mega Adapter 2.0/Mega Adapter 2.0.22b.STL
promega3d-parts/External Filter Fan/RV4/External Filter Fan_RV4_LD_2.STL
promega3d-parts/External Filter Fan/RV7/External Filter Fan_RV7_6.STL
promega3d-parts/Quad-Mega Adapter/Mega Adapter 1.0/Mega Adapter_1.STL
promega3d-parts/Quad-Mega Adapter/Mega Adapter 2.0/Mega Adapter 2.0.14.STL
promega3d-parts/Sliders/RV7/Slider_RV7_7.STL
promega3d-parts/Nozzle Fan Guide/Nozzle Fan Guide 2.0/Nozzle Fan Guide 2.0.11.STL
promega3d-parts/Quad-Mega Adapter/Mega Adapter 1.0/Mega Adapter_2.STL
promega3d-parts/Sliders/RV7/Slider_RV7_5.STL
promega3d-parts/External Filter Fan/RV3/External Filter Fan_RV3_RightFilter_6.STL
promega3d-parts/External Filter Fan/RV7/External Filter Fan_RV7_7.STL
promega3d-parts/Quad-Mega Adapter/Mega Adapter 2.0/Mega Adapter 2.0.9.STL
promega3d-parts/Sliders/RV7/Slider_RV7_3.STL
promega3d-parts/Quad-Mega Adapter/Mega Adapter 1.0/Mega Adapter Mirrored_3.STL
promega3d-parts/External Filter Fan/RV7/External Filter Fan_RV7_10.STL
promega3d-parts/Nozzle Fan Guide/Nozzle Fan Guide 2.0/Nozzle Fan Guide 2.0.8.STL
promega3d-parts/Quad-Mega Adapter/Mega Adapter 1.0/Mega Adapter_3.STL
promega3d-parts/Quad-Mega Adapter/Mega Adapter 2.0/Mega Adapter 2.0.11.STL
promega3d-parts/External Filter Fan/RV3/External Filter Fan_RV3_RightDuct_5.STL
promega3d-parts/External Filter Fan/RV4/External Filter Fan_RV4_RFC_3.STL
promega3d-parts/Nozzle Fan Guide/Nozzle Fan Guide 2.0/Nozzle Fan Guide 2.0.16.STL
promega3d-parts/Nozzle Fan Guide/Nozzle Fan Guide 2.0/Nozzle Fan Guide 2.0.9.STEP
promega3d-parts/Quad-Mega Adapter/Mega Adapter 2.0/Mega Adapter 2.0.19.STL
promega3d-parts/External Filter Fan/RV3/External Filter Fan_RV3_LeftFilter_5.STL
promega3d-parts/External Filter Fan/RV4/External Filter Fan_RV4_RD_3.STL
promega3d-parts/External Filter Fan/RV7/External Filter Fan_RV7_8.STL
promega3d-parts/External Filter Fan/RV4/External Filter Fan_RV4_LFC_2.STL
promega3d-parts/Nozzle Fan Guide/Nozzle Fan Guide 2.0/Nozzle Fan Guide 2.0.3.STL
promega3d-parts/Quad-Mega Adapter/Mega Adapter 2.0/Mega Adapter 2.0.21.STL
promega3d-parts/Nozzle Fan Guide/Nozzle Fan Guide 2.0/Nozzle Fan Guide 2.0.13.STL
promega3d-parts/Quad-Mega Adapter/Mega Adapter 2.0/Mega Adapter 2.0.22.STL
promega3d-parts/Nozzle Fan Guide/Nozzle Fan Guide 2.0/Nozzle Fan Guide 2.0.17.STL
promega3d-parts/Quad-Mega Adapter/Mega Adapter 2.0/Mega Adapter 2.0.22c.STL
promega3d-parts/Nozzle Fan Guide/Nozzle Fan Guide 2.0/Nozzle Fan Guide 2.0.6.STL
promega3d-parts/Quad-Mega Adapter/Mega Adapter 2.0/Mega Adapter 2.0.12.STL
promega3d-parts/Quad-Mega Adapter/Mega Adapter 2.0/Mega Adapter 2.0.2.STL
promega3d-parts/Nozzle Fan Guide/Nozzle Fan Guide 2.0/Nozzle Fan Guide 2.0.4.STL
promega3d-parts/Quad-Mega Adapter/Mega Adapter 2.0/Mega Adapter 2.0.20.STL
promega3d-parts/Quad-Mega Adapter/Mega Adapter 2.0/Mega Adapter 2.0.22d.STL
promega3d-parts/Quad-Mega Adapter/Mega Adapter 2.0/Mega Adapter 2.0.6.STL
promega3d-parts/Quad-Mega Adapter/Mega Adapter 2.0/Mega Adapter 2.0.17.STL
promega3d-parts/Quad-Mega Adapter/Mega Adapter 2.0/Mega Adapter 2.0.13.STL
promega3d-parts/Nozzle Fan Guide/Nozzle Fan Guide 2.0/Nozzle Fan Guide 2.0.9.STL
promega3d-parts/Plastic Inserts (Wall-E)/Compound Mixing/058124_A2 Plastic Insert_MIXING_RV3.STEP
promega3d-parts/Plastic Inserts (Wall-E)/Single K_Tana/058122_A4 Plastic Insert_SINGE_RV3.STEP
promega3d-parts/Sliders/RV14 (Experimental)/051296_B4 Z Slider_RV14_6.STL
promega3d-parts/X Limit Switch Holder/RV6/051166_A1_X_Limit_Switch_Holder_RV6.STEP
promega3d-parts/Y Limit Housing XL(For Long Motors)/Y Limit Housing XL V2_1.stl
promega3d-parts/Y Limit Switch Holder/Y Limit Switch Holder_RV3_10.STL
promega3d-parts/Z Probe Holder/Housing/051174_A2 Bed Limit Housing.STL
promega3d-parts/Z Probe Holder/Slider/051176_A2 Bed Limit Slider.STL
