msmcs-robotics/3d-models/promega3d-parts/Nozzle Fan Guide/Nozzle Fan Guide 2.0/Revision Notes.rtf

Revision Notes:
Nozzle Fan Guide 2.0.1:
• Merged previous design into a single part. Lower fixation point of printed part from top of CS screws to bottom of CS screws.
• Accomplishments: Merging of 2-part item sucesfull.
• Issues: Need to bring back M4 nuts as spacers.
Nozzle Fan Guide 2.0.2:
• Removed M4 nut spacers. Had to shift CS fan back, as well. Printed part fixated to Wall-E. CS fan fixated to printed part via screw.
• Accomplishments: Removal of M4 nut spacers was sucessfull.
• Issues: CS fan may be hindered in CFM output because of being too close to the Wall-E.
Nozzle Fan Guide 2.0.3:
• Shifted CS tap hole/block to the front.
• Accomplishments: CS fan forward shift successfull. Palpable backpressure airflow on the intake portion of the CS fan is not present anymore. Implication: increased CFM flow.
• Issues: CS fan is offset forward by 1.5 mm. Physical hits belts.
Nozzle Fan Guide 2.0.4:
• Accounted for print inaccuracies for tap block dimensions.
• Accomplishments: CS fan does not hit the CoreXY belts.
• Issues: The printed part tilts forward, exposing the heater block to the CS fan flow.
Nozzle Fan Guide 2.0.5 ( & Nozzle Fan Guide 2.0.5):
• Added fixation of the bottom part of printed part for better stability.
• Accomplishments: Eliminated the tilting of printed part.
• Issues: Nozzle fan is a 3-part item. Asked for a change to slot fixation of the CS fan.
Nozzle Fan Guide 2.0.6:
• Combined the 3-part item into one. Changed to CS fan slot fixation
• Accomplishments: Merging was sucesfull
• Issues: Sagging does not allow printed part to fixate into correct position (tilting issue has come back). CS fan slot is too narrow on the thicknss side.
Nozzle Fan Guide 2.0.7:
• Accounted for sagging (1.5mm) of the intergate clip.
• Accomplishments: Accomodation worked with the sagging clip. CS fan fixates properly in slot.
• Issues: Bottom bar's clip (used to hook the Wall-E, right about the heater block) is not reliable/consistent for production printing.
Nozzle Fan Guide 2.0.8:
• Deemed unnecessary for fixation. Will rely on snug fit (minimal clearance) for tilting prevention Removed the outer clip from the bottom bar.
• Accomplishments: Removed saggin hook/clip from bottom bar. More consistent results with identical prints.
• Issues: Bottom bar (closest to the heated block) started sagging due to heat, during print tests.
Nozzle Fan Guide 2.0.9:
• Increased volume of the bottom bar.
• Accomplishments: Has yet to sag with a 3hr print.
• Issues: Softening of the bottom bar continues with prolonged prints. Inconsistent y axis restraint of the nozzle
Nozzle Fan Guide 2.0.10:
• Increased the air gap between the heater block and the bottom bar to ~ 3.7 mm. This air gap increase was regional and positioned based on the results of previous iterations with distinct softened/wavy regions. Added a hybrid clip configuration to the bottom bar. Increased nozzle fan clip length, used to restrain the nozzle in the Y axis.
• Accomplishment: Regular temperature conditions do not cause melting. Fixation is much more secure.
• Issues: Will start to melt with the high temperature ranges. Printing errors with fins.
Nozzle Fan Guide 2.0.11:
• Fixed prinitng error with fins. Address the melting region with high temp. conditions
• Accomplishments: Fins fixed.
• Issues: No motor duct cooling. Form factor needs work.
Nozzle Fan Guide 2.0.12:
• Added motor duct. To keep slot fixation, moved slot entry to bottom. Minor adjustment to form factor by raising fans higher (close to limit).
• Accomplishments: Motor cooling is present. Slot entry modification sucessfull. Nozzle fan installation successfull.
• Issues: The motor duct is too long. Need to reduce height.
Nozzle Fan Guide 2.0.13:
• Focused on adding a more harmonious form factor. Covered the CS fan to reveal only the M3 thru holes and CS spinning fan. Angled the fan duct.
• Accomplishments: Form factor is better in comparison to previous designs.
• Issues: Minor asesthetic issues continue.
Nozzle Fan Guide 2.0.14:
• Additional form factor addition. Added more cohesive look to the top region of the fan duct. Had to convert nozzle fan insert from top to back side. Added wire clearance for the nozzle as well.Reduced the duct height to 2mm behind walle front face.
• Accomplishments: Form factor improved. Nozzle fan wire clearance is succesfful. Nozzle fan insert sucessfull.
• Issues: Nozzle fan fixation is a bit loose. Will fix when noticed.
Nozzle Fan Guide 2.0.15:
• Minor asesthetic changes. Included side ducts to the motor duct region.
• Accomplishments: Asesthetic changes approved.
• Issues: Additional minor asesthetic changes.
Nozzle Fan Guide 2.0.16:
• Minor asesthetic changes. More cohesive alignement with Wall-E. Uses M3 x 10 mm screws.
• Accomplishments: Asesthetics improved.
• Issues: New request for using a M3 x 12 mm screws.
Nozzle Fan Guide 2.0.17:
• Switching to M3 x 12 mm screws. Change to M3 thru hole ( 4 mm).
• Accomplishments: Switch was successfull.
• Issues: Needs larger cold section fan slot clearance.
• Intended Extrusion Parameters: < 0.6 mm extrusion width, < 0.3 mm layer height
Nozzle Fan Guide 2.0.18:
• Switching to M3 x 12 mm screws. Change to M3 thru hole ( 4 mm).
• Accomplishments: Slot clearance is now successful.
• Issues: Bed adhesion on the sharp corners is not successful enough
• Intended Extrusion Parameters: < 0.6 mm extrusion width, < 0.3 mm layer height
Nozzle Fan Guide 2.0.19:
• Added custom brims.
• Accomplishments: Bed adhesion more consistent
• Issues: Pending.
• Intended Extrusion Parameters: < (not equal to) 0.6 mm extrusion width, < 0.3 mm layer height
• Crucial Slicer Settings For Cleaner & Successfull prints
1. Outer Wall Line Width = 0.55 (all other widths can be 0.6)
2. Wall Line Count = 2
3. Top Layers = 3+ (Not crucial, will help top layer finishing look)
4. Bottom Pattern Initial Layer = Concentric (Not crucial, but helps with avoiding lifting of extrusion due to sharp turns)
5. Print Thin Walls = Disable.
6. Fill Gaps Between Walls = Nowhere.
7. Build Plate Adhesion Type = Skirt (Not crucial, the 2.0.19 has custom brims. So, adding skirt is like a brim+skirt combo)
(Use the search bar in cura to find these settings).
