msmcs-robotics/3d-models/promega3d-parts/Sliders/RV14 (Experimental)/Revision Notes.rtf

Revision Notes:
051296_B4 Z Slider_RV14_6:
• This is a cumulation of multiple iterations of the same concept. Verified to work with HIPS only.
• Accomplishment: Adjustable frictional loading. High (relatively) deflection value (increase print longevity). +-0.4mm Continous Z height adjust for physical bed leveling
• Issues: Needs print quality comparisons.
