msmcs-robotics/3d-models/(commit log)

2022-01-12 3d printer parts
    [051166_A1_X_Limit_Switch_Holder_RV6.STEP, 051174_A2 Bed Limit Housing.STL, 051176_A2 Bed Limit Slider.STL, 051296_B4 Z Slider_RV14_6.STL, 058122_A4 Plastic Insert_SINGE_RV3.STEP, 058124_A2 Plastic Insert_MIXING_RV3.STEP, External Filter Fan RV5_1.STL, External Filter Fan RV5_2.STL]
2022-01-28 init mini rockets
    [051166_A1_X_Limit_Switch_Holder_RV6.STEP, 051174_A2 Bed Limit Housing.STL, 051176_A2 Bed Limit Slider.STL, 051296_B4 Z Slider_RV14_6.STL, 058122_A4 Plastic Insert_SINGE_RV3.STEP, 058124_A2 Plastic Insert_MIXING_RV3.STEP, External Filter Fan RV5_1.STL, External Filter Fan RV5_2.STL]
